pcbnerd/cameraboard/doc/ov5640-camera-diagram.jpg

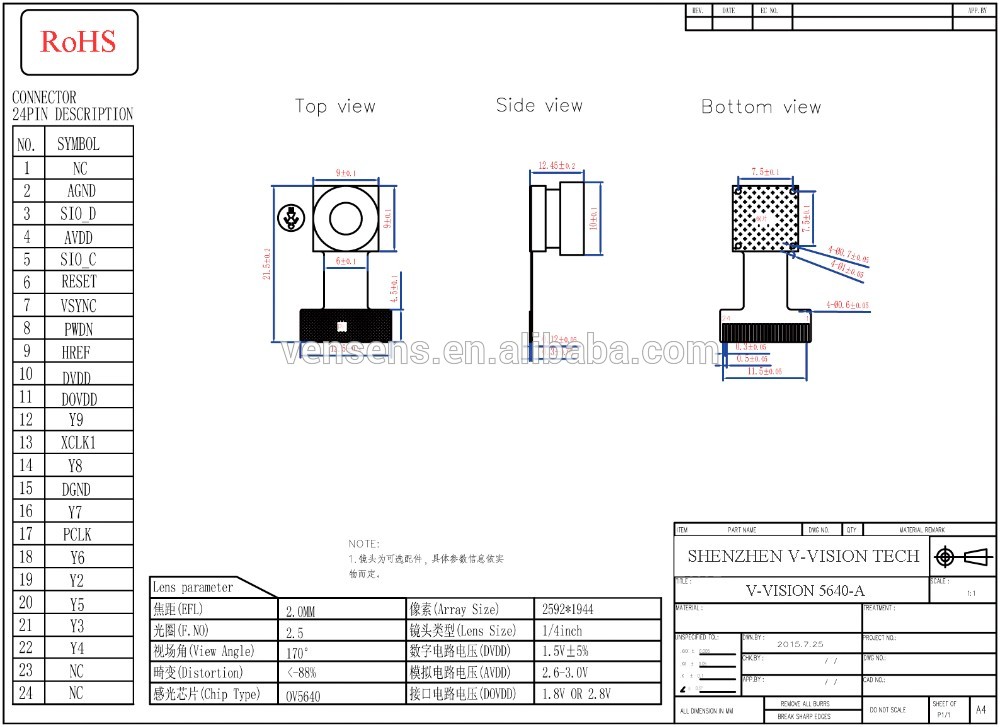
doc/ov5640-camera-diagram.jpg
