pcbnerd/cameraboard/custom-components/3d-models/keystone-PN55.STEP

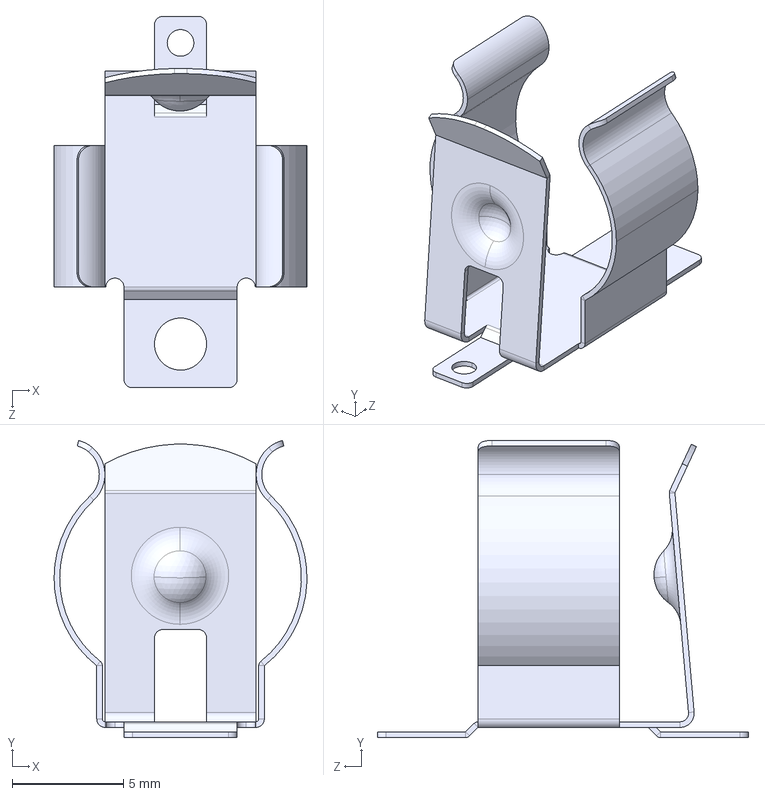
[picture p2: CAD file, 2019-09-28]
custom-components/3d-models/keystone-PN55.STEP
11.3 x 13.3 x 16.7 mm
