pcbnerd/cameraboard/custom-components/3d-models/keystone-PN1022.STEP

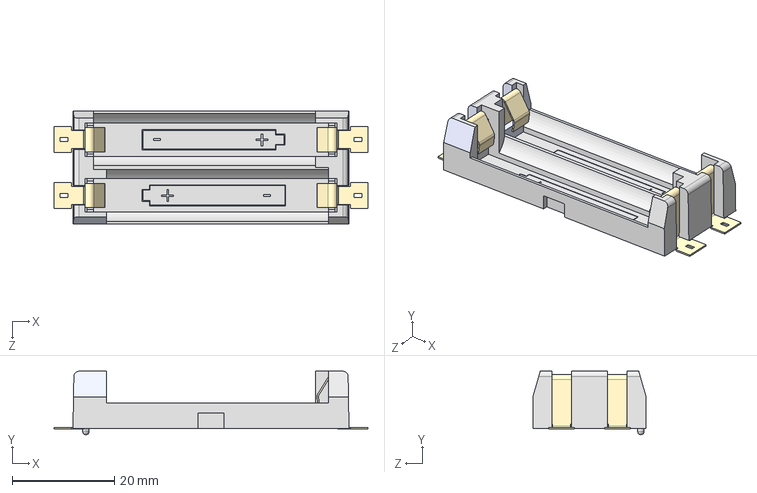
[picture p3: CAD file, 2019-09-28]
custom-components/3d-models/keystone-PN1022.STEP
61.5 x 12.4 x 22.2 mm
