pcbnerd/cameraboard/custom-components/3d-models/battery-AAA.step

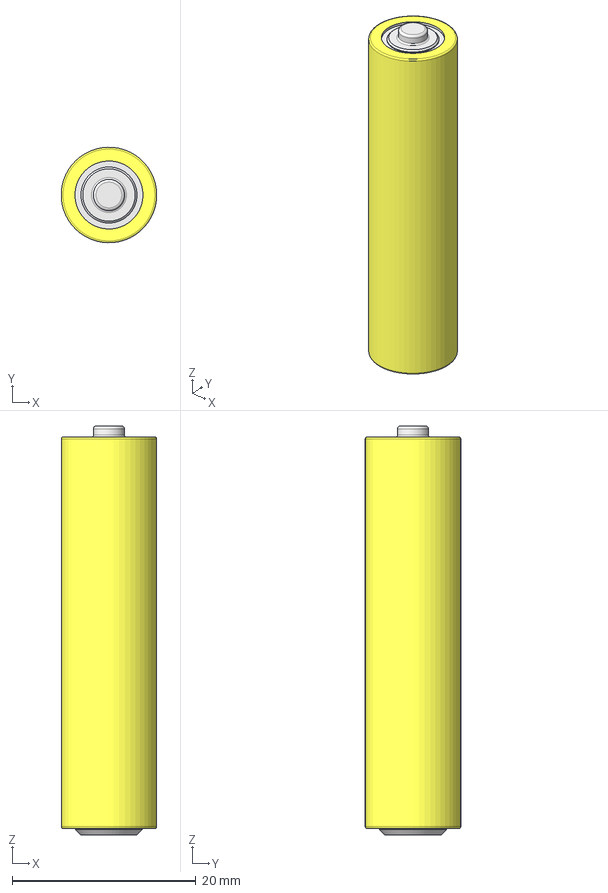
[picture p4: CAD file, 2019-09-28]
custom-components/3d-models/battery-AAA.step
10.4 x 10.4 x 44.5 mm
