pcbnerd/cameraboard/custom-components/3d-models/FH12-50S-0.5SH.stp

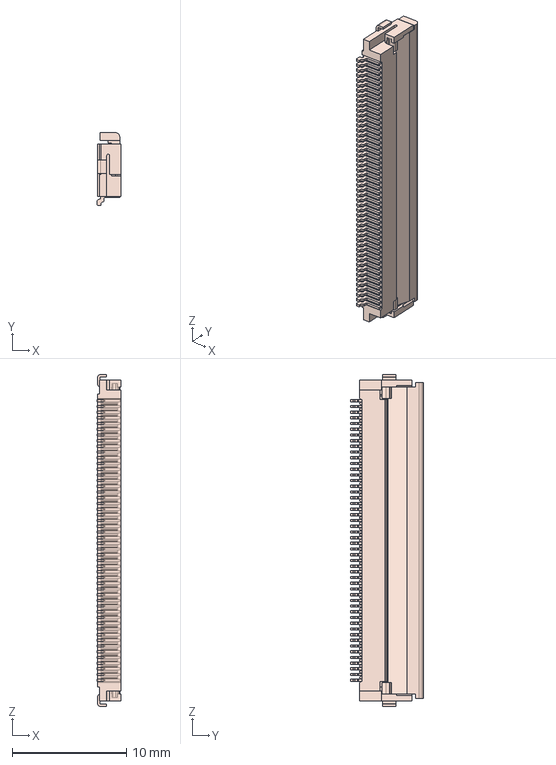
[picture p5: CAD file, 2019-09-28]
custom-components/3d-models/FH12-50S-0.5SH.stp
2.10 x 6.40 x 29.1 mm
