pcbnerd/cameraboard/(commit log)

2019-09-28 Initial rev with MK82 + LCD + camera
    [FH12-50S-0.5SH.stp, battery-AAA.step, keystone-PN1022.STEP, keystone-PN55.STEP, lcdboard.kicad_pcb, lcdboard.sch]
2019-09-28 Connect backlight supply to VREGIN
    [lcdboard.kicad_pcb, lcdboard.sch]
2019-09-28 Add external oscillator
    [lcdboard.kicad_pcb, lcdboard.sch]
2019-09-28 Add pull-up to JTAG_TRST and remove from header
    [lcdboard.kicad_pcb, lcdboard.sch]
2019-09-28 Rewire JTAG & UART to use 6-pin connectors
    [lcdboard.kicad_pcb, lcdboard.sch]
2019-09-28 Add alignment pins to LCD footprint
    [lcdboard.kicad_pcb]
2019-09-28 Add r-packs to LCD signals to reduce EMI
    [lcdboard.kicad_pcb, lcdboard.sch]
2019-09-28 Reposition backlight driver
    [lcdboard.kicad_pcb]
2019-09-28 Add board library cache
    [lcdboard.kicad_pcb]
